venusjoel/JA-Achtung-Full/docs/portfolio/JA-Achtung-Project-Presentation.pdf

## Project A Final Report

# Tiny Tapeout ASIC Project

# ‘Achtung, die Kurve!’

Presented by: Amit Elmaliach & Joel Kaplan

Mentor: Roy Treves | Technion – Israel Institute of Technology VLSI Lab

# Background & Motivation

### Overcoming stringent silicon area limits to build a fully functional, multiplayer

hardware game.

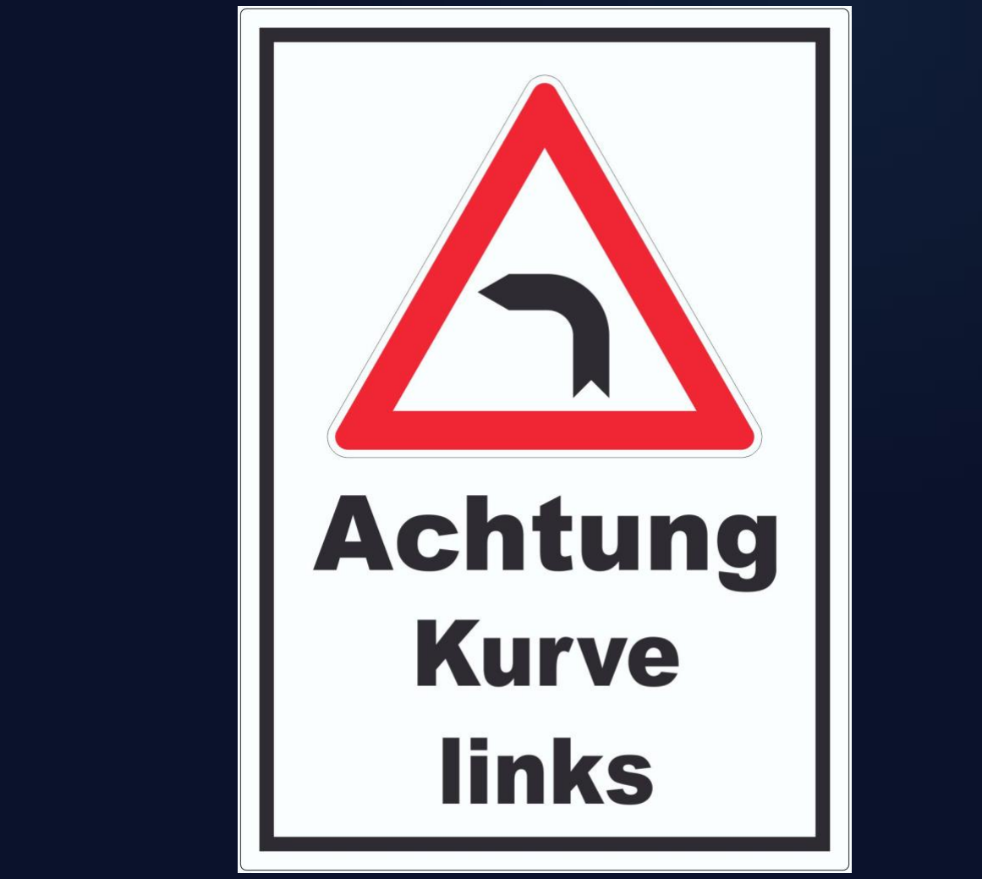
[picture p10: figure]

Application Specific Integrated Circuits (ASICs) represent the pinnacle of digital design, but open-source platforms like Tiny Tapeout impose strict standard-cell boundaries.

Storing a 640x480 high-resolution video framebuffer within internal flip-flops is physically impossible in a 1x1 or 1x2 tile constraint.

'Achtung, die Kurve!' requires storing persistent trails, meaning the entire board state must be constantly read and rendered.

Solution: We developed a custom QSPI PSRAM controller (APS6404L) to offload video memory to an external chip.

# The Core Challenge

# Why External PSRAM Is Essential

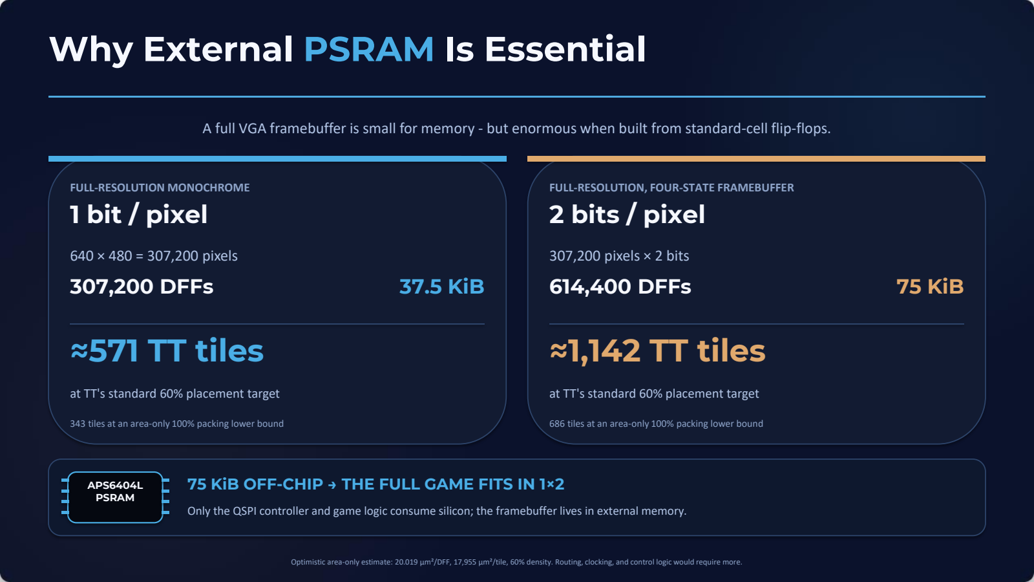
[picture p11: page 4]

A full VGA framebuffer is small for memory - but enormous when built from standard-cell flip-flops.

FULL-RESOLUTION MONOCHROME

# 1 bit / pixel

640 × 480 = 307,200 pixels
307,200 DFFs | 37.5 KiB

# ≈571 TT tiles

at TT's standard 60% placement target

343 tiles at an area-only 100% packing lower bound

FULL-RESOLUTION, FOUR-STATE FRAMEBUFFER

# 2 bits / pixel

307,200 pixels × 2 bits
614,400 DFFs | 75 KiB

# ≈1,142 TT tiles

at TT's standard 60% placement target

686 tiles at an area-only 100% packing lower bound

APS6404L
PSRAM

### 75 KiB OFF-CHIP → THE FULL GAME FITS IN 1×2

Only the QSPI controller and game logic consume silicon; the framebuffer lives in external memory.

Optimistic area-only estimate: 20.019 µm²/DFF, 17,955 µm²/tile, 60% density. Routing, clocking, and control logic would require more.

An educational project democratizing access to silicon manufacturing by lowering costs and simplifying the toolchain.

Multi-Project Wafer (MPW): Combines multiple independent user designs onto a single physical silicon chip to share manufacturing costs.

Open-Source Tools: Relies entirely on open-source Electronic Design Automation (EDA) flows, such as LibreLane and the sky130 PDK.

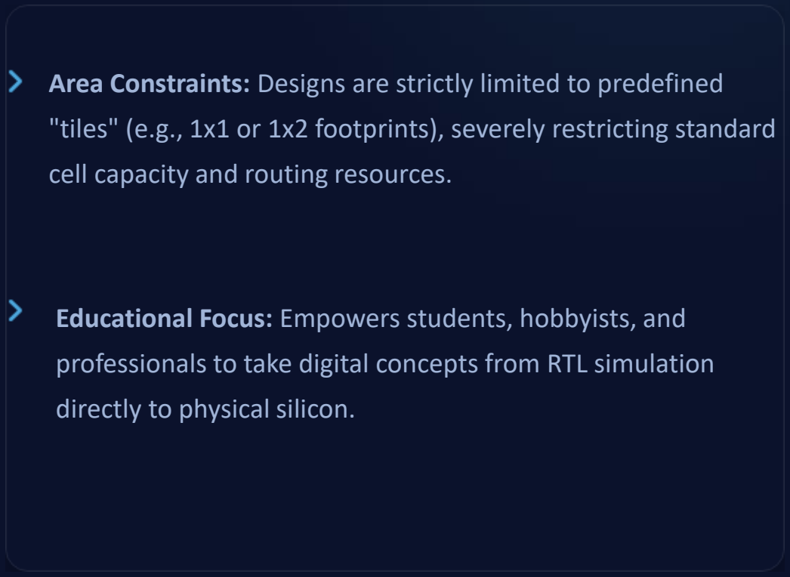
[picture p12: figure]
cell capacity and routing resources.; directly to physical silicon.

Area Constraints: Designs are strictly limited to predefined "tiles" (e.g., 1x1 or 1x2 footprints), severely restricting standard

Educational Focus: Empowers students, hobbyists, and professionals to take digital concepts from RTL simulation

# What is Tiny Tapeout?

# System Demonstration

1×1 "Compact" | 1×2 "Full"

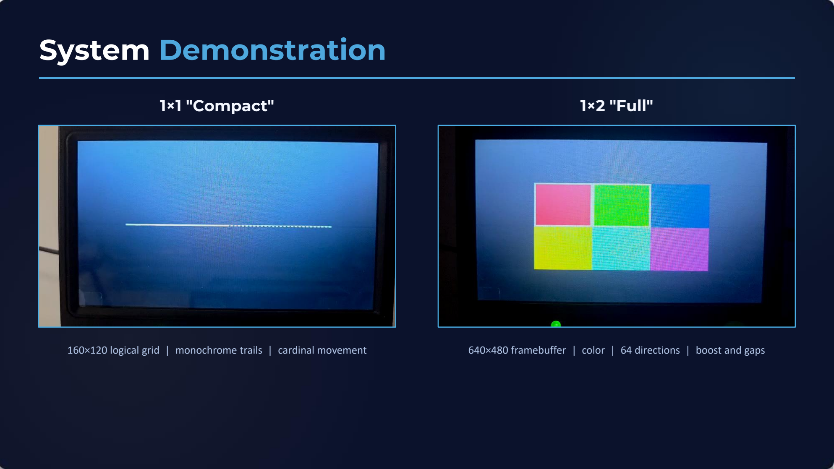
[picture p13: page 6]

160×120 logical grid | monochrome trails | cardinal movement | 640×480 framebuffer | color | 64 directions | boost and gaps

To evaluate area vs. features, we created two standalone ASIC projects.

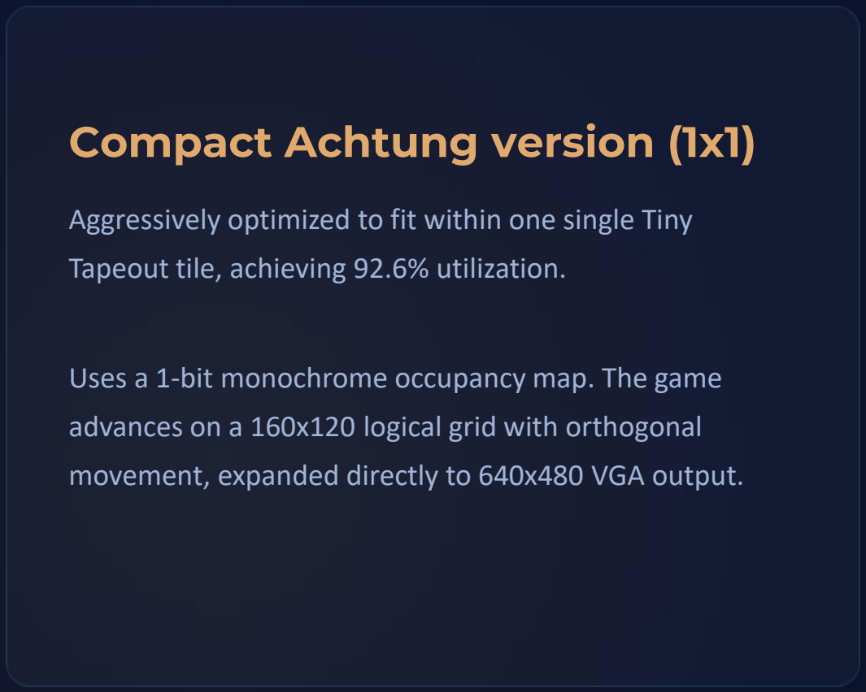
[picture p14: figure]
Compact Achtung version (1x1)

Aggressively optimized to fit within one single Tiny Tapeout tile, achieving 92.6% utilization.

Uses a 1-bit monochrome occupancy map. The game advances on a 160x120 logical grid with orthogonal movement, expanded directly to 640x480 VGA output.

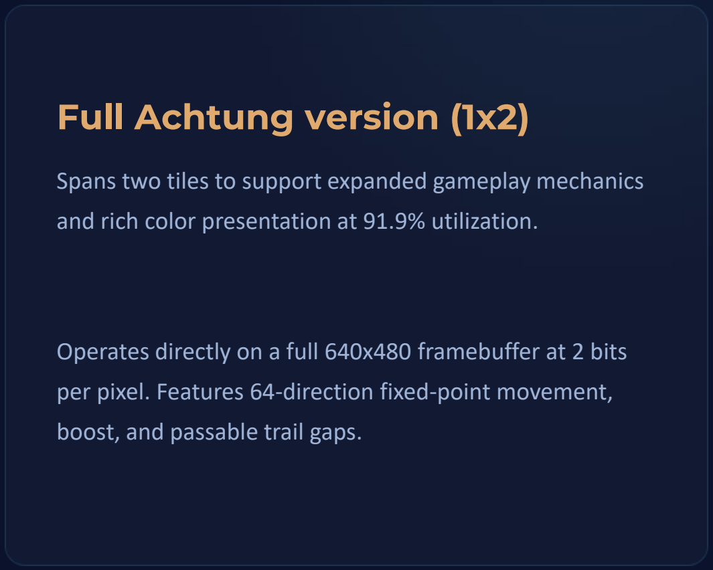
[picture p15: figure]
Full Achtung version (1x2); boost, and passable trail gaps.

Spans two tiles to support expanded gameplay mechanics and rich color presentation at 91.9% utilization.

Operates directly on a full 640x480 framebuffer at 2 bits per pixel. Features 64-direction fixed-point movement,

# Two Independent Implementations

To implement a full gaming system within ASIC boundaries, our design interfaces with several external components via the TT carrier board:

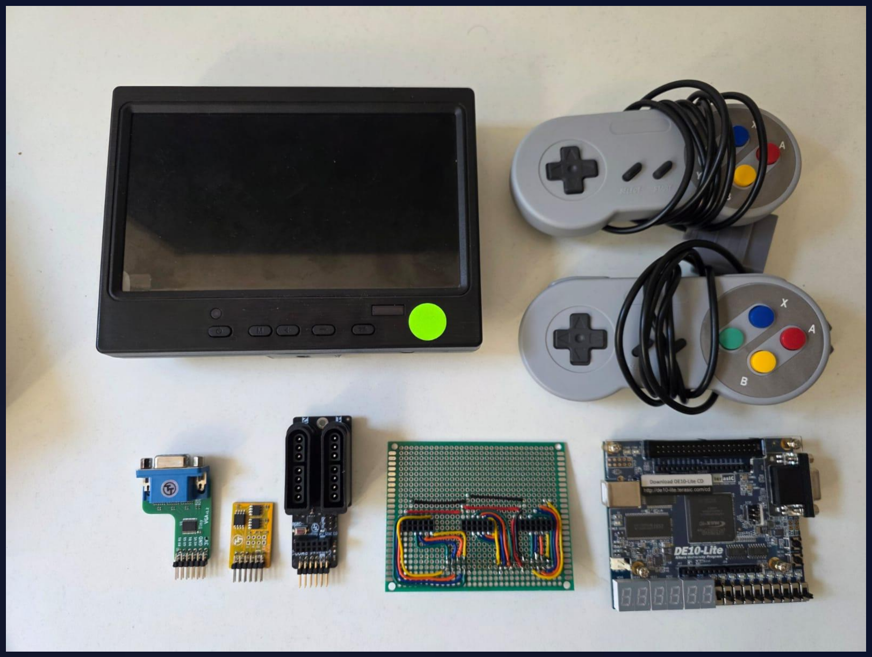
[picture p16: figure]

Tiny Tapeout ASIC: The physical silicon hosting our synthesized Game FSM, VGA Sync, and memory arbitration logic.

External PSRAM (APS6404L): A high-speed, quad-SPI memory chip providing 8 MiB of external framebuffer memory.

Gamepad PMOD: A physical interface board allowing two standard SNES-style controllers to communicate serially with the ASIC.

VGA Breakout: Drives the analog color signals and sync pulses directly to a standard 640x480 computer monitor.

# Physical Hardware Components

# Architecture Diagram

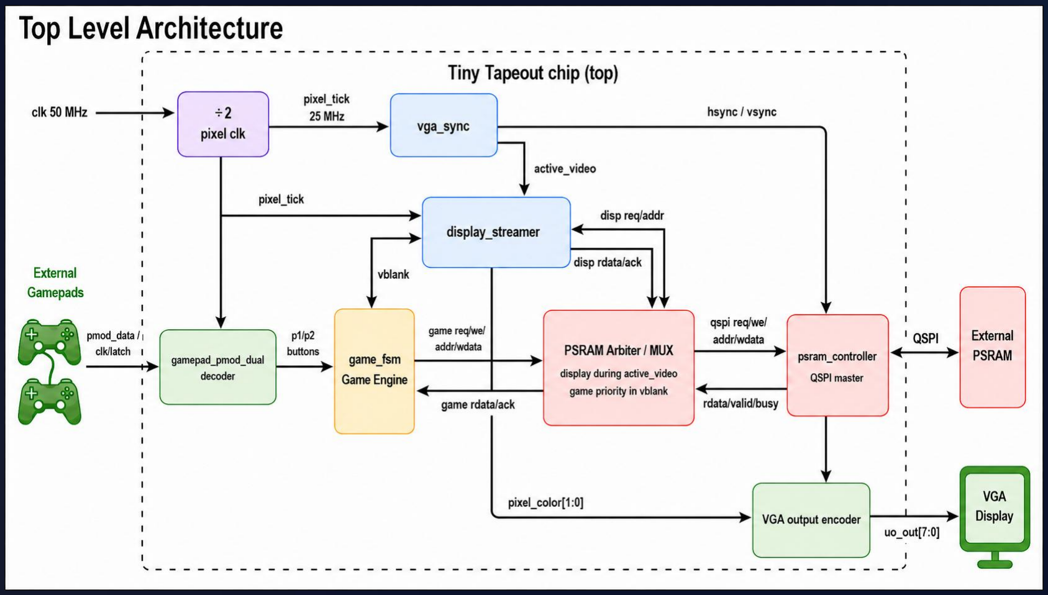
[picture p17: figure]

# Top Level Architecture

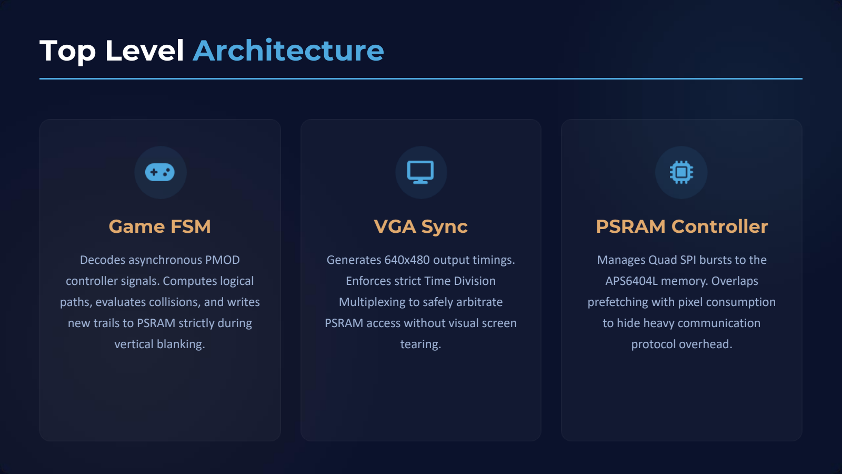
[picture p18: page 10]

# Game FSM

Decodes asynchronous PMOD
controller signals. Computes logical paths, evaluates collisions, and writes new trails to PSRAM strictly during vertical blanking.

# VGA Sync

Generates 640x480 output timings. Enforces strict Time Division Multiplexing to safely arbitrate PSRAM access without visual screen tearing.

# PSRAM Controller

Manages Quad SPI bursts to the APS6404L memory. Overlaps
prefetching with pixel consumption to hide heavy communication protocol overhead.

# Simplified Game State Machine

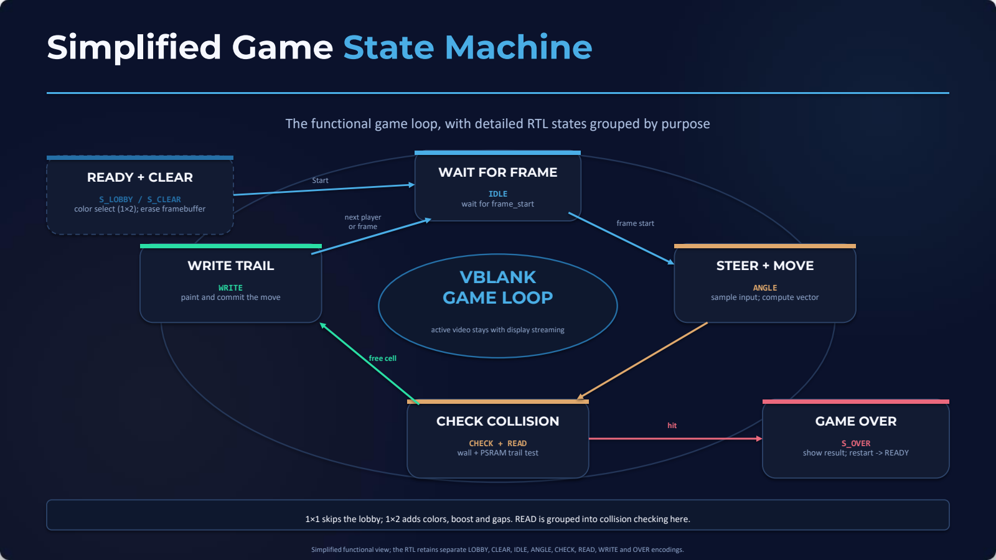
[picture p19: page 11]

The functional game loop, with detailed RTL states grouped by purpose

WAIT FOR FRAME

IDLE
wait for frame_start

STEER + MOVE

ANGLE
sample input; compute vector

CHECK COLLISION

CHECK + READ
wall + PSRAM trail test

WRITE TRAIL

WRITE
paint and commit the move

frame start

free cell

next player
or frame

## VBLANK GAME LOOP

active video stays with display streaming

READY + CLEAR

S_LOBBY / S_CLEAR
color select (1×2); erase framebuffer

Start

GAME OVER

S_OVER
show result; restart -> READY

hit

1×1 skips the lobby; 1×2 adds colors, boost and gaps. READ is grouped into collision checking here.

Simplified functional view; the RTL retains separate LOBBY, CLEAR, IDLE, ANGLE, CHECK, READ, WRITE and OVER encodings.

# 25 MHz

## PSRAM SCLK LIMIT

# Why direct reading fails:

While the PSRAM supports 133 MHz burst, Tiny Tapeout's output-switching limit sets the practical clock bound to roughly 25 MHz.

A visible pixel is consumed on every 25 MHz cycle.

PSRAM requires multiple cycles for Command, Address, and Wait phases before returning data.

The Fix: We engineered packed framebuffer data combined with overlapped prefetching to ensure the display outpaces memory latency.

# The Memory Bottleneck

# The Memory Bottleneck – Ping Pong Buffers

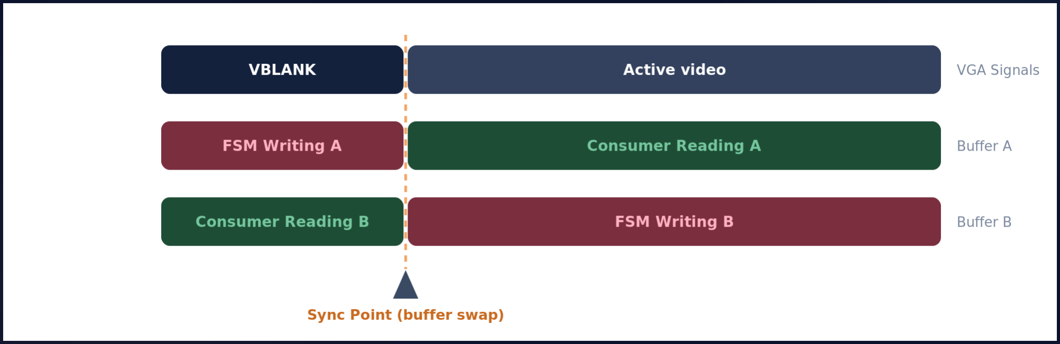
[picture p20: figure]

For the 1x2 full-game target (2 bits per physical pixel), we calculated the exact burst size (N bytes) required to prevent pixel starvation.

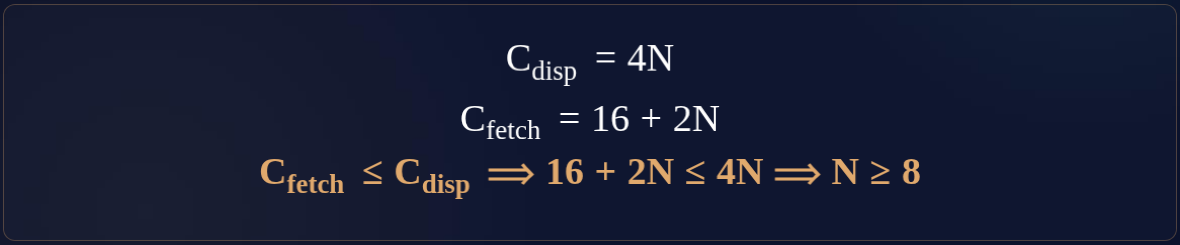
[picture p21: figure]

An 8-byte burst is the absolute minimum threshold to sustain a 640x480 VGA stream at 25 MHz.

# Buffer Sizing Mathematical Analysis

Choosing an 8-byte burst prevents display starvation while keeping flip-flop utilization safely within Tiny Tapeout's strict standard-cell constraints.

Buffer Size | Display Time (Cycles) | Fetch Time (Cycles) | Status | Naive Storage Cost
1 Byte (8-bit) | 4 | 18 | FAIL (Starvation) | 16 FFs
4 Bytes (32-bit) | 16 | 24 | FAIL (Fetch lags) | 64 FFs
8 Bytes (64-bit) | 32 | 32 | PASS (Chosen for 1x2) | 128 FFs (Optimal)
16 Bytes (128-bit) | 64 | 48 | PASS (Margin) | 256 FFs (Wasteful)

# Buffer Sizing & Resource Tradeoff

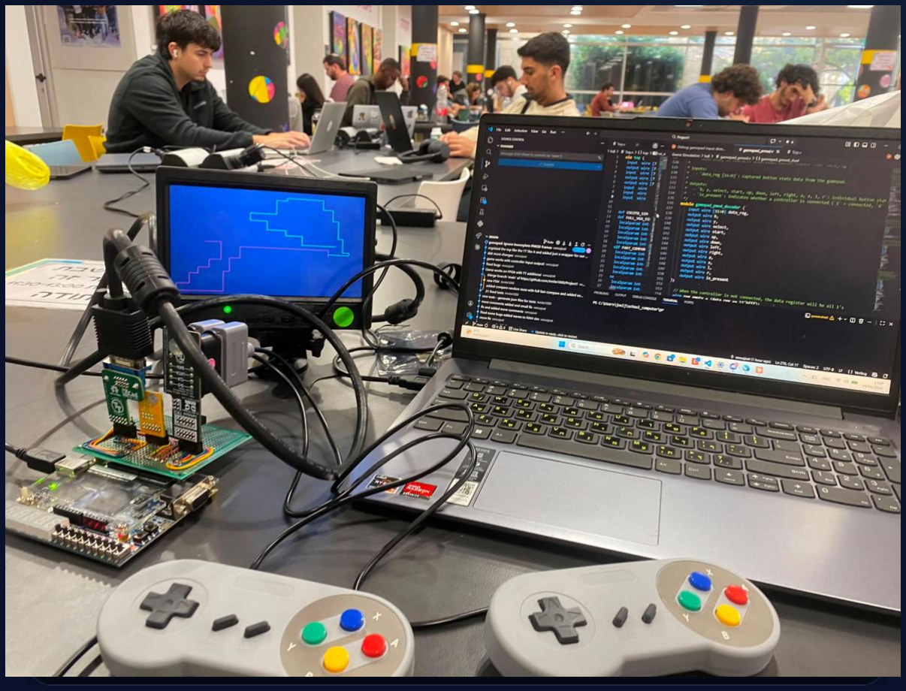
[picture p22: figure]

Verifying ASIC memory interactions requires rigorous, automated testing far beyond manual waveform inspection.

Python Behavioral Models: Serve as an independent source of truth (test oracle).

Deterministic JSON Traces: Record and execute repeatable, frame-by-frame gameplay inputs for stress testing.

Automated Equivalence Checking: Compares final PSRAM framebuffer maps bit-for-bit between Python and RTL.

Subsystem Testing: Includes pixel-exact VGA capture verification and full gate-level smoke tests.

# Verification Methodology

# Live Hardware Demonstration

# Synthesis & Layout Results

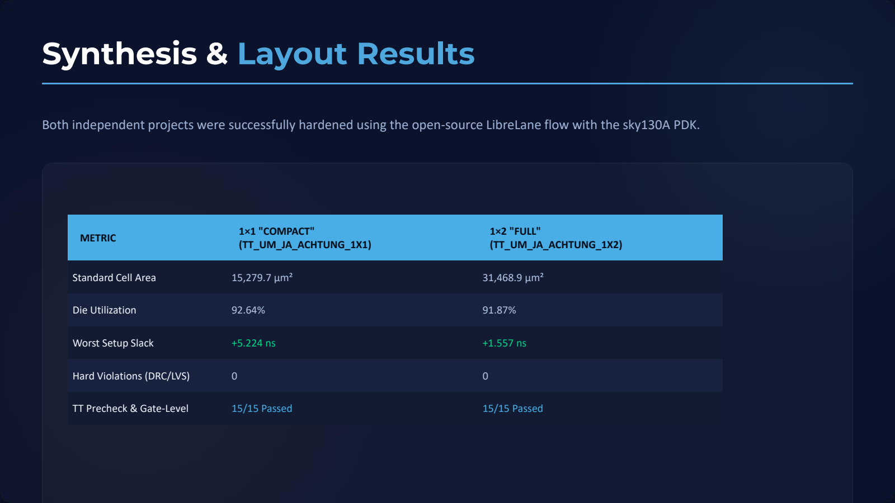
[picture p23: page 18]

Both independent projects were successfully hardened using the open-source LibreLane flow with the sky130A PDK.

METRIC | 1×1 "COMPACT" (TT_UM_JA_ACHTUNG_1X1) | 1×2 "FULL" (TT_UM_JA_ACHTUNG_1X2)
Standard Cell Area | 15,279.7 µm² | 31,468.9 µm²
Die Utilization | 92.64% | 91.87%
Worst Setup Slack | +5.224 ns | +1.557 ns
Hard Violations (DRC/LVS) | 0 | 0
TT Precheck & Gate-Level | 15/15 Passed | 15/15 Passed

The final step before manufacturing is generating the physical geometric masks, known as the GDSII format.

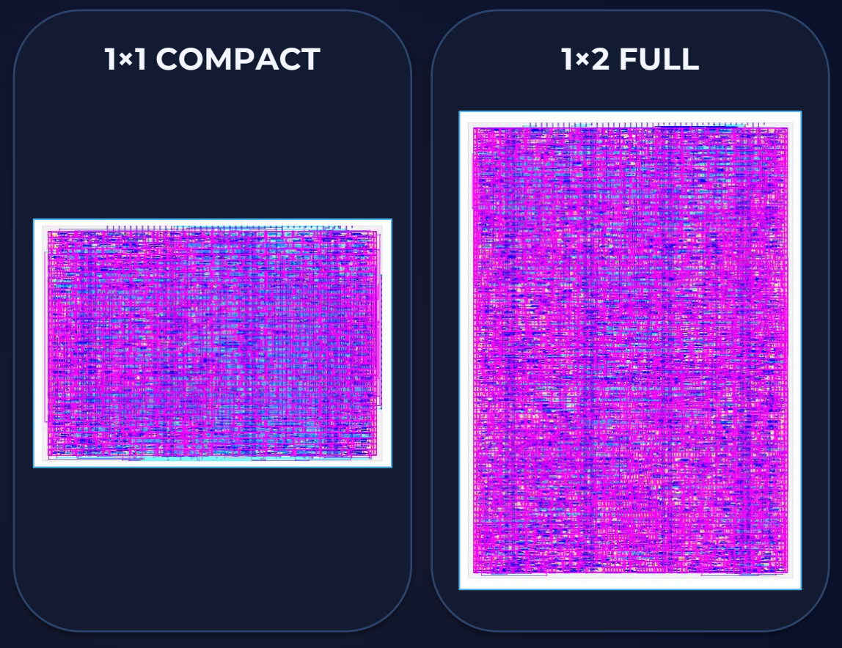
[picture p24: figure]
1×1 COMPACT; 1×2 FULL

Standard Cell Placement: Every logic gate from the RTL is physically placed within the designated 1x1 or 1x2 tile boundary.

Routing & Interconnects: The OpenLane/LibreLane flow automatically routes microscopic metal layers to connect the components.

Density Optimization: Final utilization reached 92.64% (1×1) and 91.87% (1×2), leaving very little unused silicon.

Signoff Checks: Confirms clean DRC geometry, LVS equivalence, antenna checks, and non-negative setup/hold timing before submission.

# Physical Layout (GDSII)

# Actual 2D GDS Density Comparison

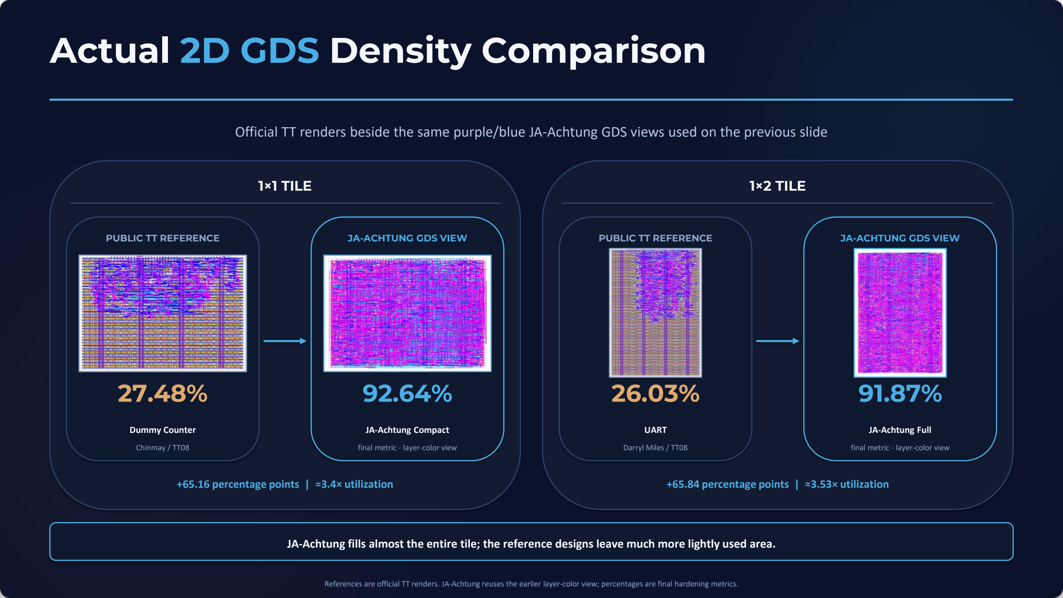
[picture p25: page 20]

Official TT renders beside the same purple/blue JA-Achtung GDS views used on the previous slide

1×1 TILE

PUBLIC TT REFERENCE | JA-ACHTUNG GDS VIEW
27.48% | 92.64%

Dummy Counter

Chinmay / TT08

JA-Achtung Compact

final metric - layer-color view

+65.16 percentage points | ≈3.4× utilization

1×2 TILE

PUBLIC TT REFERENCE | JA-ACHTUNG GDS VIEW
26.03% | 91.87%

UART

Darryl Miles / TT08

JA-Achtung Full

final metric - layer-color view

+65.84 percentage points | ≈3.53× utilization

JA-Achtung fills almost the entire tile; the reference designs leave much more lightly used area.

References are official TT renders. JA-Achtung reuses the earlier layer-color view; percentages are final hardening metrics.

# 3D Physical Layout

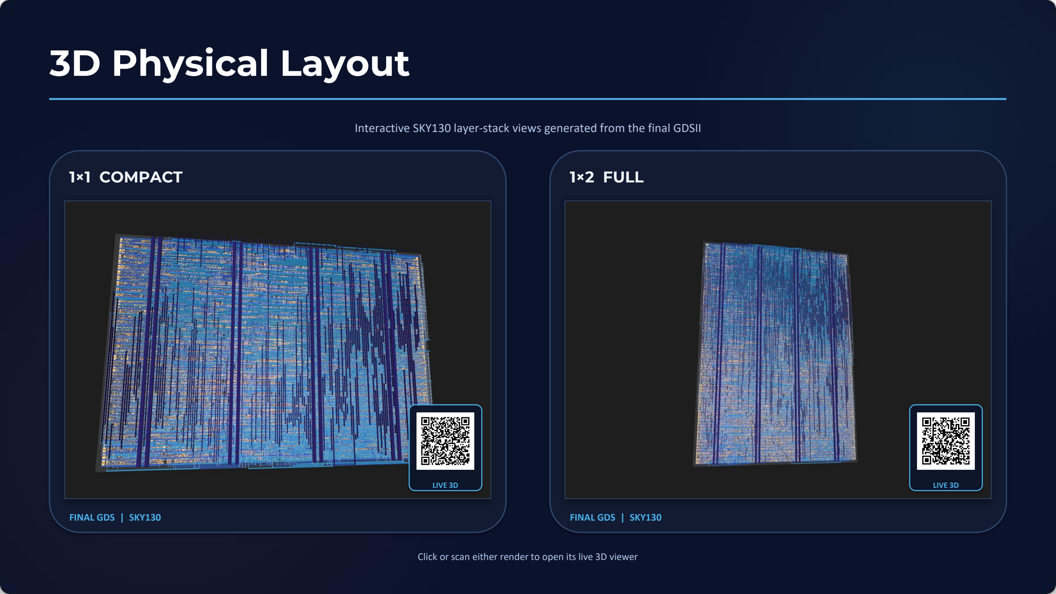
[picture p26: page 21]

Interactive SKY130 layer-stack views generated from the final GDSII

1×1 COMPACT | 1×2 FULL
Three-dimensional SKY130 layer-stack view of the final 1x1 Compact GDSII. (https://venusjoel.github.io/JA-Achtung-Compact/) | Three-dimensional SKY130 layer-stack view of the final 1x2 Full GDSII. (https://venusjoel.github.io/JA-Achtung-Full/)
FINAL GDS | SKY130 | FINAL GDS | SKY130

Click or scan either render to open its live 3D viewer

QR code opening the live 1x1 Compact Tiny Tapeout 3D viewer.

LIVE 3D (https://venusjoel.github.io/JA-Achtung-Compact/)

QR code opening the live 1x2 Full Tiny Tapeout 3D viewer.

LIVE 3D (https://venusjoel.github.io/JA-Achtung-Full/)

# Why This Project Stands Out

A distinctive combination of system integration, physical-design density, and evidence-driven optimization

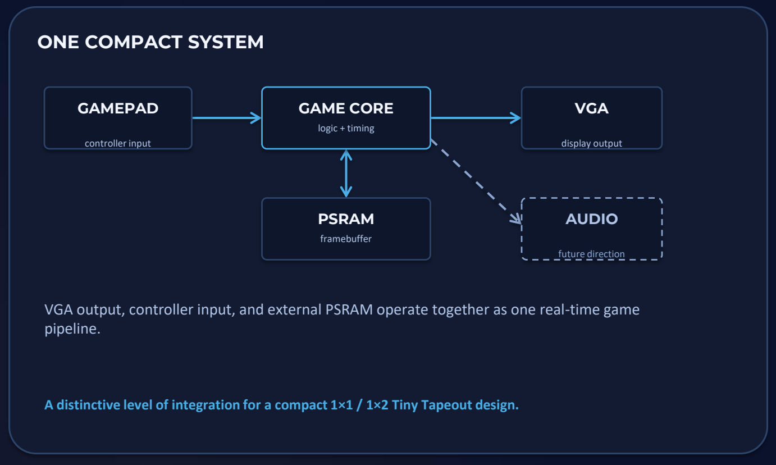
[picture p27: figure]
ONE COMPACT SYSTEM; GAMEPAD; controller input; GAME CORE; logic + timing; VGA; display output; PSRAM; framebuffer; AUDIO; future direction; pipeline.

VGA output, controller input, and external PSRAM operate together as one real-time game

A distinctive level of integration for a compact 1×1 / 1×2 Tiny Tapeout design.

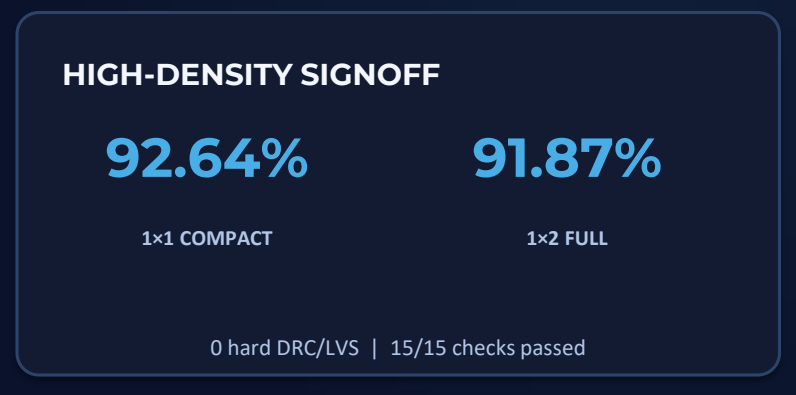
[picture p28: figure]
HIGH-DENSITY SIGNOFF; 1×1 COMPACT; 1×2 FULL; 0 hard DRC/LVS | 15/15 checks passed
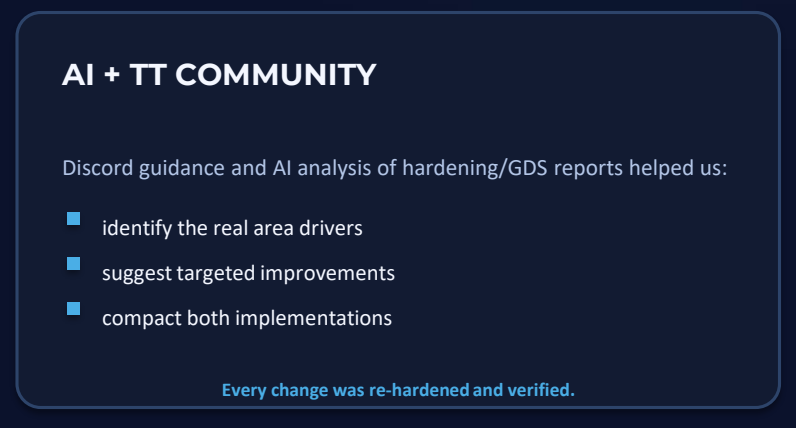
[picture p29: figure]
AI + TT COMMUNITY; identify the real area drivers; suggest targeted improvements; compact both implementations

Discord guidance and AI analysis of hardening/GDS reports helped us:

Every change was re-hardened and verified.

AI's strongest role: fast physical-design analysis - not a replacement for engineering judgment or verification.

# How We Fit the Game into 1×1 / 1×2

We optimized synthesized hardware - not simply lines of source code.

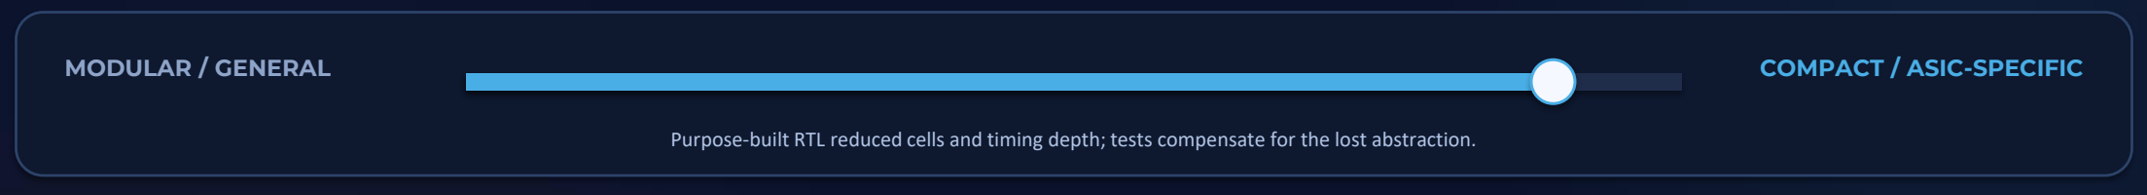
[picture p30: figure]
MODULAR / GENERAL; COMPACT / ASIC-SPECIFIC

Purpose-built RTL reduced cells and timing depth; tests compensate for the lost abstraction.

DESIGN DECISION | AREA / TIMING WIN | TRADE-OFF
SELECTIVE ABSTRACTION | Share PSRAM control and buffers across module boundaries. | Tighter ownership assumptions
ALIGN + NARROW | Pack pixels/bursts; omit address bits known to be zero. | Fixed geometry and burst sizes
SHIFTS + SLICES | Shift-add and bit slices replace x20/x160 and /4,/8,/64. | Scaling assumptions enter RTL
ONE MUXED DATAPATH | Both players share movement, collision and address logic. | More manual selection logic
FIXED DIRECTION LUT | 16 quarter-wave vectors generate all 64 headings. | Fixed precision; table upkeep
Smaller / faster hardware | tighter coupling, fixed assumptions, less immediate readability | 92.64% | 91.87%

Comments, cocotb, deterministic replay, equivalence checks and repeated hardening kept each optimization safe.

# Summary & Future Work

### Preparing for physical silicon bring-up, validating I/O timing, and exploring analog

enhancements.

# Questions?

Thank you for your attention.

Technion – Israel Institute of Technology | VLSI Lab
