venusjoel/JA-Achtung-Full/(commit log)

2026-07-23 Add chip visuals to README (#1)
    Add the exact current GDS render, system architecture diagram, hardware metrics, and interactive 3D viewer link to the public README.
2026-07-23 Use current pink GDS render (#2)
    Replace the dark README preview with the exact current pink KLayout render from the successful GDS build.
